dkm/startracker/3d_models/slide_head.stl

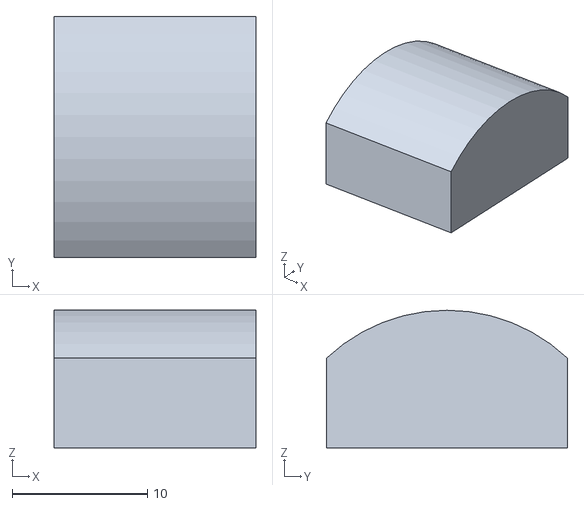
[picture p1: CAD file, 2019-07-14]
3d_models/slide_head.stl
14.9 x 17.8 x 10.2
