dkm/startracker/3d_models/slide_bar.stl

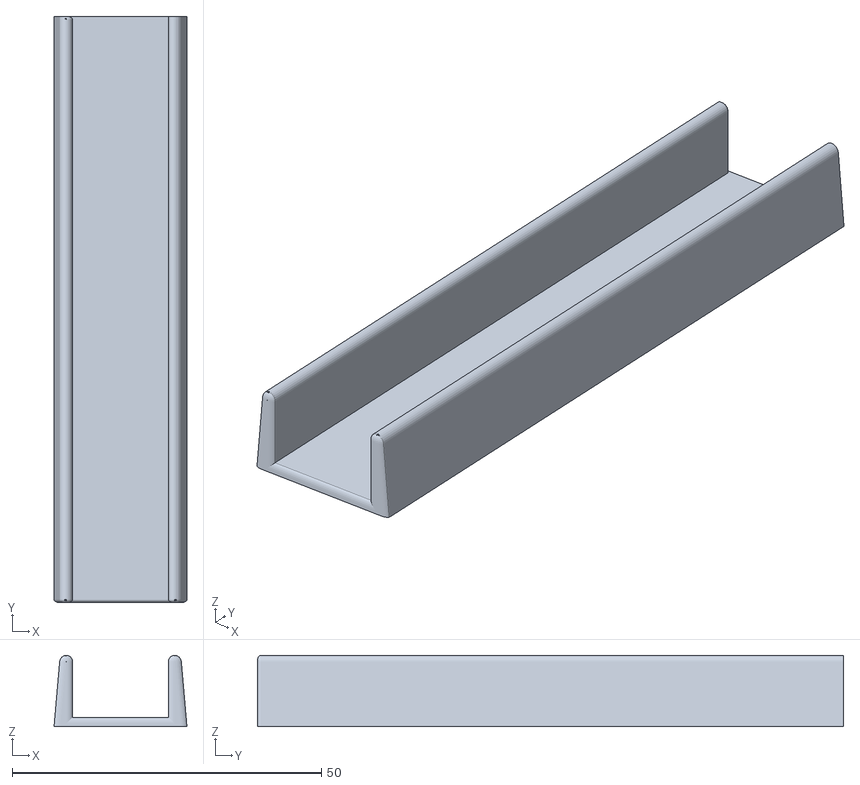
[picture p2: CAD file, 2019-07-14]
3d_models/slide_bar.stl
21.5 x 94.8 x 11.5
