dkm/startracker/3d_models/big_gear.stl

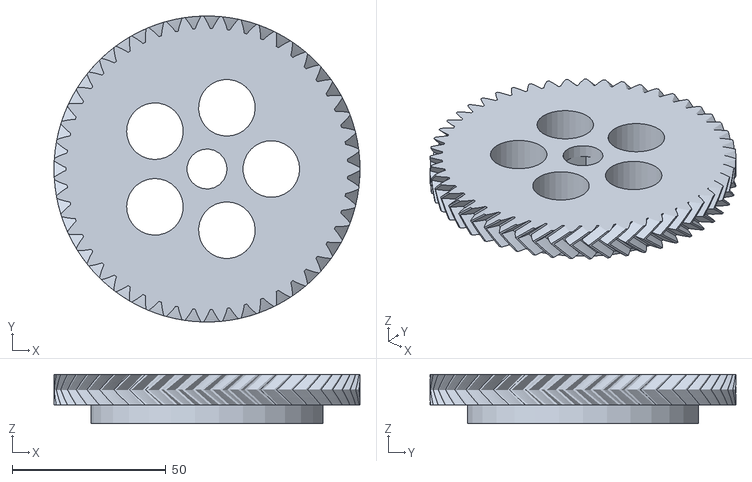
[picture p3: CAD file, 2019-07-06]
3d_models/big_gear.stl
99.4 x 99.4 x 16.0
