dkm/startracker/3d_models/motor_gear.stl

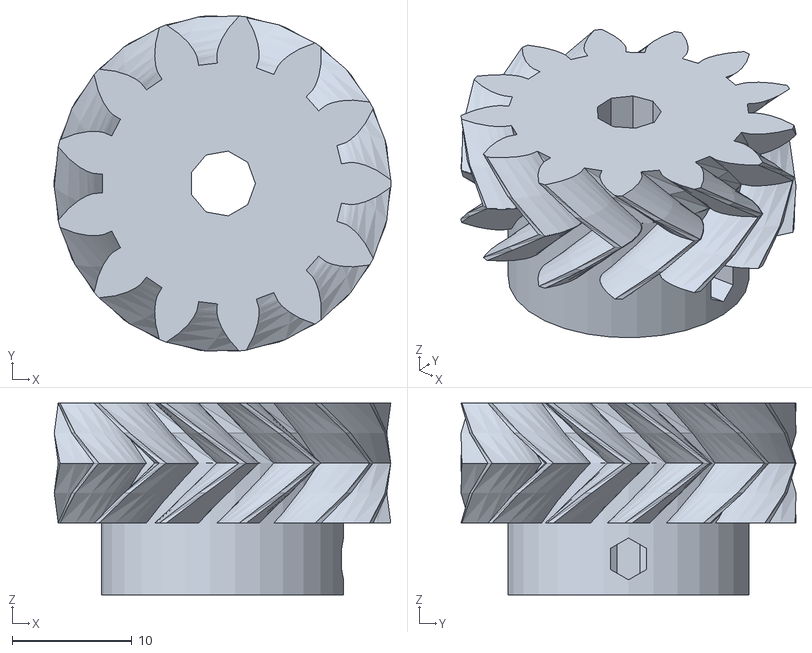
[picture p4: CAD file, 2019-07-06]
3d_models/motor_gear.stl
28.1 x 28.0 x 16.0
