dkm/startracker/3d_models/rod_holder.stl

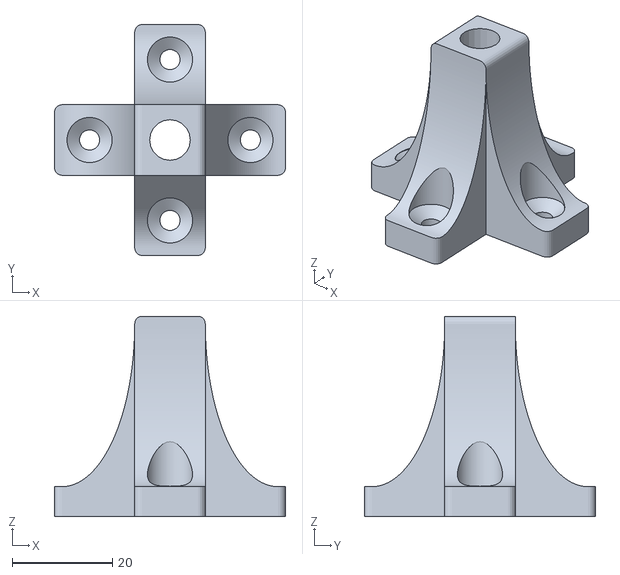
[picture p5: CAD file, 2019-01-20]
3d_models/rod_holder.stl
46.1 x 46.1 x 40.0
