dkm/startracker/3d_models/laser_holder_301.stl

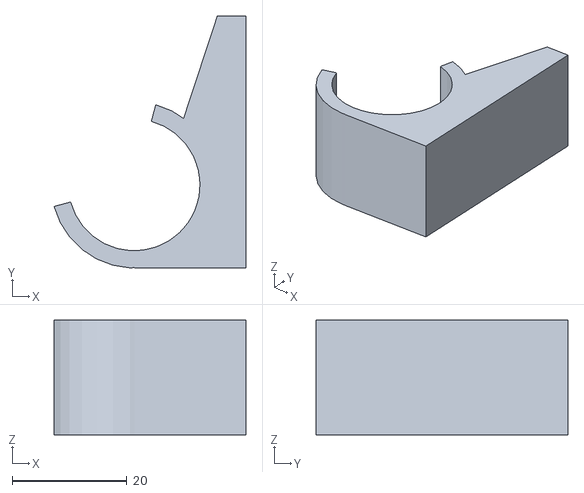
[picture p6: CAD file, 2018-05-30]
3d_models/laser_holder_301.stl
33.5 x 44.0 x 20.0
