dkm/startracker/3d_models/end_stop_pad.stl

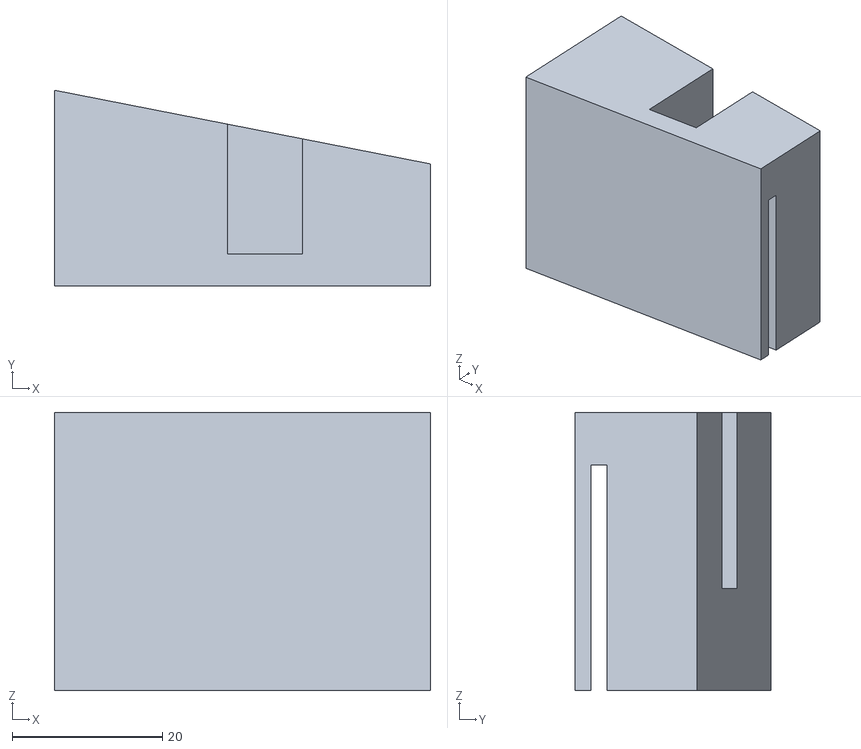
[picture p7: CAD file, 2018-02-28]
3d_models/end_stop_pad.stl
50.0 x 26.0 x 37.0
