dkm/startracker/3d_models/stepper_cover.stl

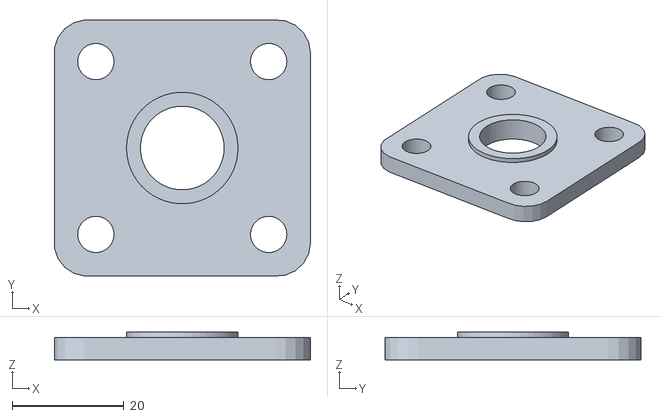
[picture p8: CAD file, 2017-06-23]
3d_models/stepper_cover.stl
45.9 x 46.0 x 5.00
