dkm/startracker/3d_models/rod_cover.stl

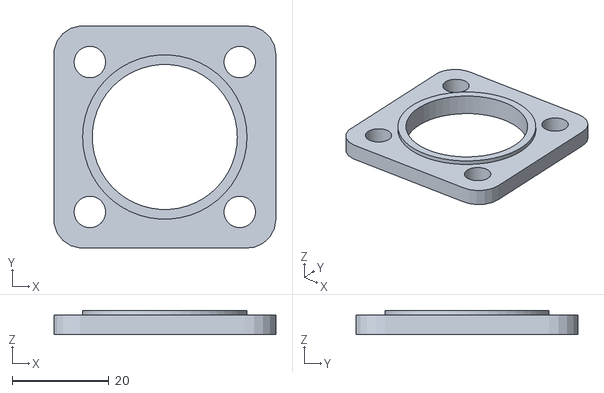
[picture p9: CAD file, 2017-06-21]
3d_models/rod_cover.stl
45.9 x 46.0 x 5.00
