dkm/startracker/3d_models/nema17braket.stl

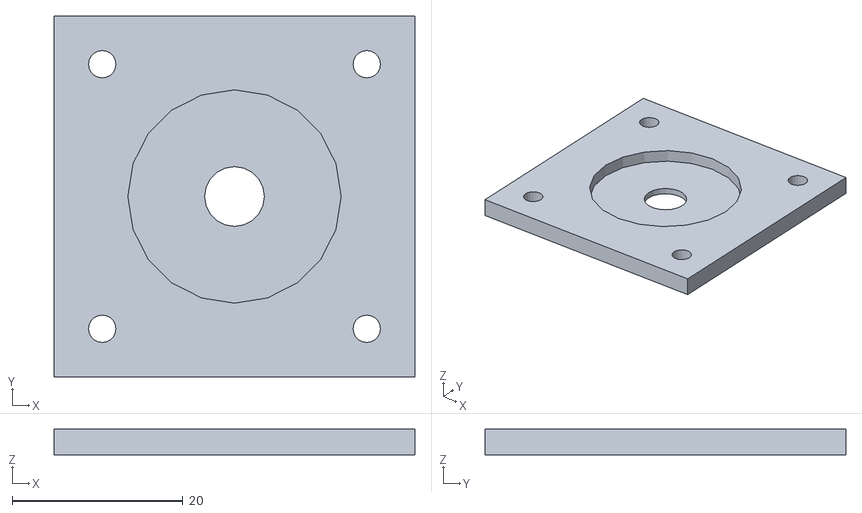
[picture p10: CAD file, 2017-06-19]
3d_models/nema17braket.stl
42.3 x 42.3 x 3.00
