dkm/startracker/3d_models/motor_gear_55shaft.stl

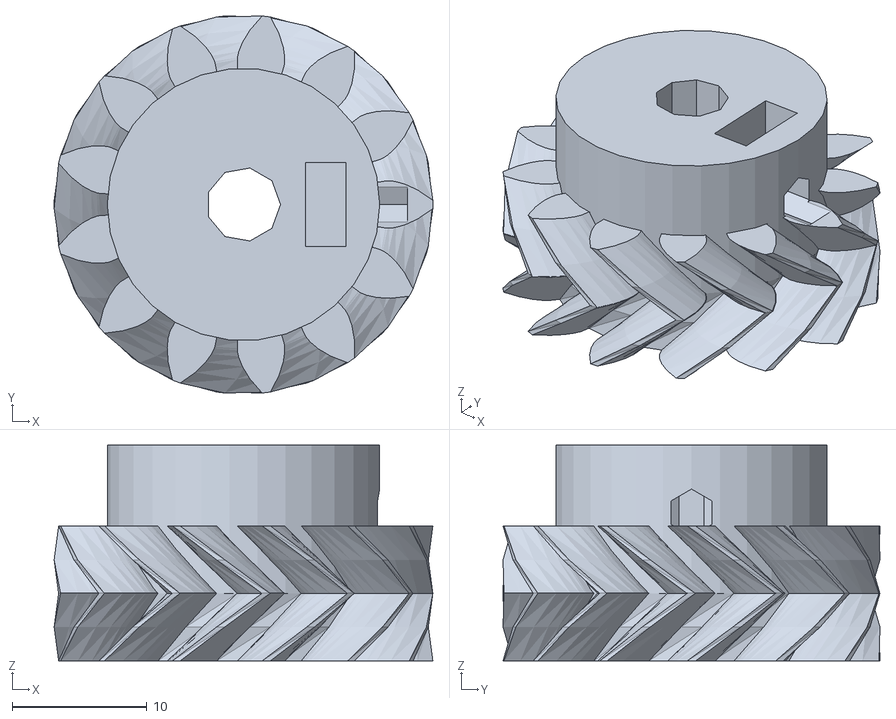
[picture p11: CAD file, 2017-06-19]
3d_models/motor_gear_55shaft.stl
28.1 x 28.0 x 16.0
