dkm/startracker/(list of files, cad)

Other CAD files:
3d_models/rod_cover.scad
