dkm/startracker/(list of files, drawings)

Other design files:
kicad/startracker.dsn
