dkm/startracker/kicad/startracker.kicad_pcb

## KiCad design kicad/startracker.kicad_pcb (2017-06-25)

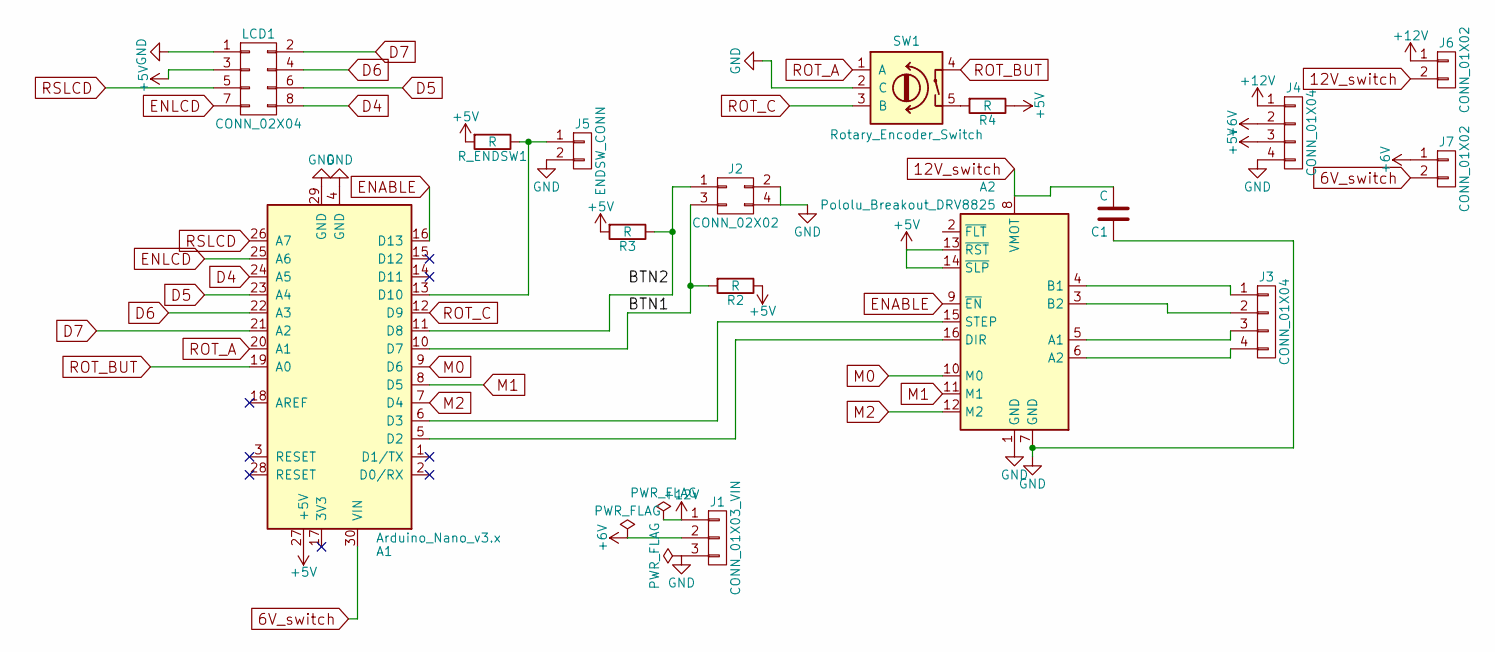
[picture p12: schematic startracker.sch]

Parts:
A1: Arduino_Nano_v3.x; Arduino_Nano_WithMountingHoles
A2: Pololu_Breakout_DRV8825; Pololu_Breakout-16_15.2x20.3mm
C1: C; C_Radial_D8_L11.5_P3.5
J1: CONN_01X03_VIN; JST_PH_B3B-PH-K_03x2.00mm_Straight
J2: CONN_02X02; Pin_Header_Straight_2x02
J3, J4: CONN_01X04; Pin_Header_Straight_1x04
J5: ENDSW_CONN; Pin_Header_Straight_1x02
J6, J7: CONN_01X02; Pin_Header_Straight_1x02
LCD1: CONN_02X04; Pin_Header_Straight_2x04
R2, R3, R4: R; Resistor_Horizontal_RM7mm
R_ENDSW1: R; Resistor_Horizontal_RM7mm
SW1: Rotary_Encoder_Switch; SF-ROTARY-ENCODER

Connections:
6V_switch: A1.30 (VIN), J7.2
12V_switch: A2.8 (VMOT), C1.2, J6.2
+5V: A1.27 (+5V), A2.13 (~RST), A2.14 (~SLP), J4.3, LCD1.3, R2.1, R3.2, R4.1, R_ENDSW1.2
+6V: J1.2, J4.2, J7.1
+12V: J1.1, J4.1, J6.1
/BTN1: A1.10 (D7), J2.3, R2.2
D4: A1.24 (A5), LCD1.8
D5: A1.23 (A4), LCD1.6
D6: A1.22 (A3), LCD1.4
D7: A1.21 (A2), LCD1.2
ENABLE: A1.16 (D13), A2.9 (~EN)
ENLCD: A1.25 (A6), LCD1.7
GND: A1.4 (GND), A1.29 (GND), A2.1 (GND), A2.7 (GND), C1.1, J1.3, J2.2, J2.4, J4.4, J5.2, LCD1.1, SW1.2 (C)
M0: A1.9 (D6), A2.10 (M0)
M1: A1.8 (D5), A2.11 (M1)
M2: A1.7 (D4), A2.12 (M2)
unnamed: A1.5 (D2), A2.16 (DIR)
unnamed: A1.6 (D3), A2.15 (STEP)
unnamed: A1.11 (D8), J2.1, R3.1
unnamed: A1.13 (D10), J5.1, R_ENDSW1.1
unnamed: A2.3 (B2), J3.2
unnamed: A2.4 (B1), J3.1
unnamed: A2.5 (A1), J3.3
unnamed: A2.6 (A2), J3.4
unnamed: R4.2, SW1.5
ROT_A: A1.20 (A1), SW1.1 (A)
ROT_BUT: A1.19 (A0), SW1.4
ROT_C: A1.12 (D9), SW1.3 (B)
RSLCD: A1.26 (A7), LCD1.5

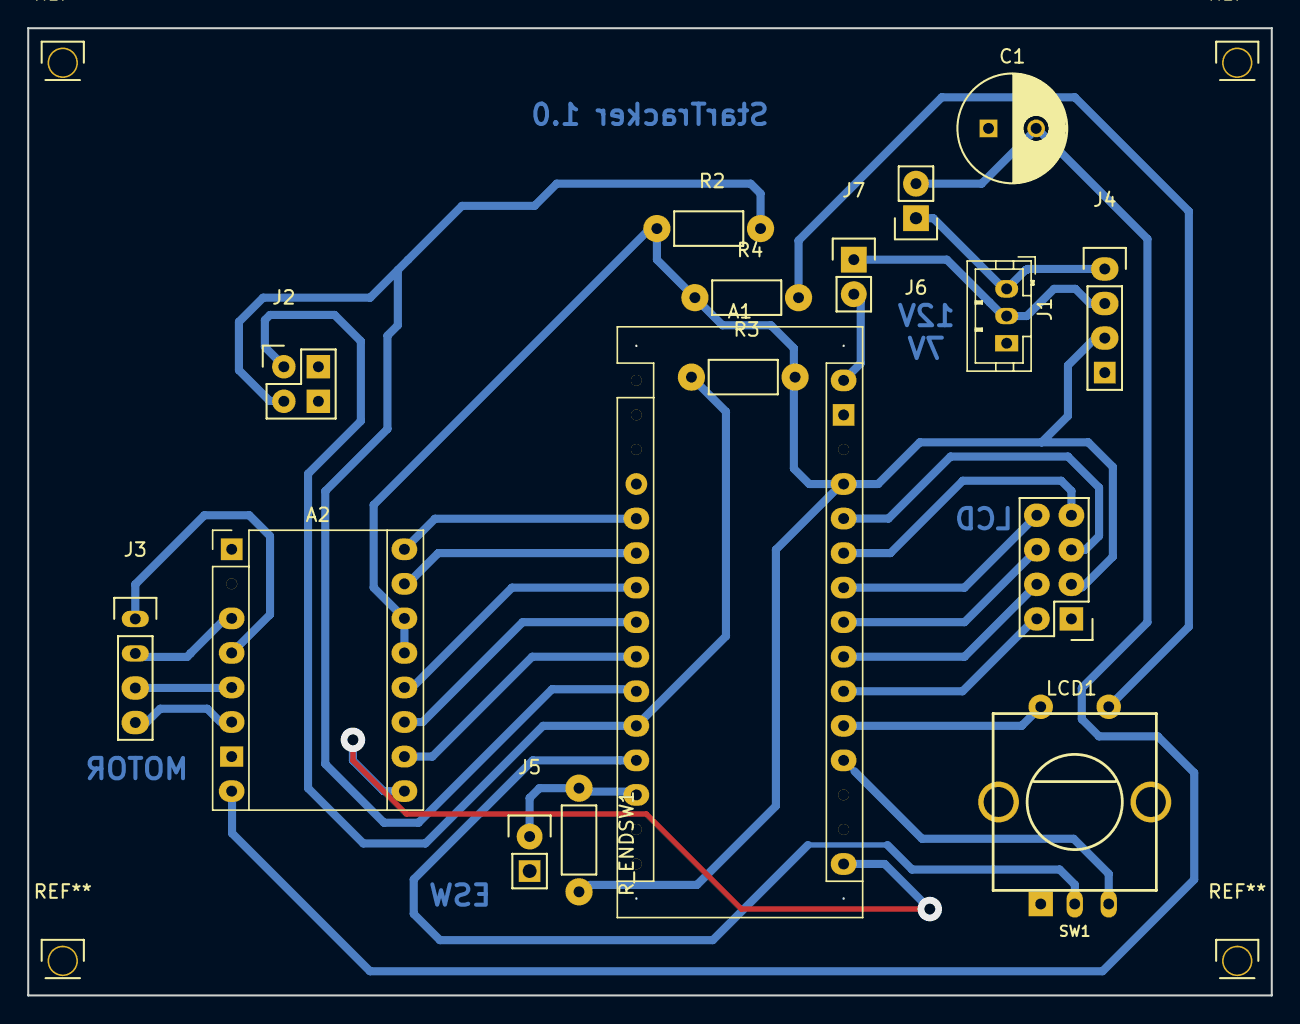
[picture p13: board startracker.kicad_pcb from above]

Board: 2 copper layers, 91.4 x 71.1 mm, 16 parts (0 on the bottom side), 29 nets.
