dkm/startracker/(commit log)

2017-05-15 first kicad draft
    [startracker.kicad_pcb, startracker.sch]
2017-05-15 sample arduino sketch for testing nema17
2017-05-16 making progress on elec sch
    [startracker.sch]
2017-05-19 add some footprint, still some issue with some components
    [startracker.sch]
2017-05-20 first pcb routed on single layer
    [startracker.kicad_pcb, startracker.sch]
2017-05-23 add 7.5V connector
    [startracker.kicad_pcb, startracker.sch]
2017-05-29 PCB fix
    [startracker.kicad_pcb]
2017-06-02 refresh pcb
    [startracker.dsn, startracker.kicad_pcb]
2017-06-08 new pcb version
    [startracker.dsn, startracker.kicad_pcb, startracker.sch]
2017-06-08 use timer1 and use makefile
    use timer1 (initial code)
    use makefile instead of arduino IDE.
2017-06-08 use StepperDriver lib
2017-06-08 add submodule with footprint libs
2017-06-08 update board : use enable, m0, ...
    [startracker.dsn, startracker.kicad_pcb, startracker.sch]
2017-06-09 reworked elec schema + pcb
    [startracker.dsn, startracker.kicad_pcb, startracker.sch]
2017-06-14 rework float computation
    looks like the arduino float is not a good fit for this one: results are
    diverging after few seconds. Fallback to some hardcoded numerical
    values.
    known problem: timer does not tick periodically
    [startracker.ino]
2017-06-15 3D models for gears
    [big_gear.stl, gears.scad, motor_gear.stl]
2017-06-15 fix angle compute + use millis
    [startracker.ino]
2017-06-19 enl4rge gear shaft hole
    [gears.scad, motor_gear_55shaft.stl]
2017-06-19 add nema17 holder plate
    [nema17braket.scad, nema17braket.stl]
2017-06-20 some cleaning + initial code for reset position
    remove dead code commented out
    initial routine for reseting position on long press
    [startracker.ino]
2017-06-20 update current state
2017-06-21 add rod cover model
    used to cover screws around rod and allow for big gear to turn.
    [rod_cover.scad, rod_cover.stl]
2017-06-21 initial work for laster holder
    [laser_holder.scad]
2017-06-21 add endstrop down to pcb
    [startracker.kicad_pcb, startracker.sch]
2017-06-22 minor changes in PCB
    add drill hole in corners
    make all GND pad rectangular
    add labels for connectors
    [startracker.kicad_pcb]
2017-06-22 PCB cleanups
    larger track size, add spacing when possible.
    [startracker.kicad_pcb]
2017-06-23 add switch connectors for both pwr (12 and 7)
    both can be shorted for using only 12V.
    [startracker.kicad_pcb, startracker.sch]
2017-06-23 Add Switch submodule for arduino
    Switch module can be used to debounce push buttons
2017-06-23 control automata basics
    start in IDLE.
    IDLE :: 1 press => RUN ; 2 press => RESET
    RUN :: 1 press => IDLE
    RESET :: end_stop => IDLE
    Stepper direction can be changed.
    Stepper microstepping can be changed.
    Some debug print used.
    [startracker.ino]
2017-06-23 Laser holder work
    Hook size nearly good
    [laser_holder.scad]
2017-06-23 Add 3D model for stepper cover
    [stepper_cover.scad, stepper_cover.stl]
2017-06-25 add weak debug routines + better state change traces
2017-06-25 change microstepping config and rotation freq
    microstepping 2->16
    freq: 0.5Hz -> 5Hz
2017-06-25 refresh config code for stepper direction
2017-06-25 minor changes in PCB
    rework edge cut, refresh some tracks/drill holes.
    [startracker.kicad_pcb]
2017-06-25 add box model (from the Ultimate Box Maker)
    http://heartygfx.blogspot.com
    OpenScad Parametric Box
    CC BY-NC 3.0 License
    [U_Box_V103.scad]
2017-06-25 model for Dolica tripod quick release mount.
    prepare for 4 M3 screws/hexnuts.
    [dolica_quick_Release.scad]
2017-06-25 add initial box model
    Based on Ultimate Box Maker
    https://www.thingiverse.com/thing:1264391
    [box.scad]
2017-06-26 laser holder nearly ready
    [laser_holder.scad]
2017-06-29 fine tune nut holes in laser holder
    [laser_holder.scad]
2017-07-02 change DRV8825 mode pins
    for easier routing, mode pins have swapped.
    [startracker.ino]
2017-07-02 fine tune laser holder
    now, radius may be a bit too large, but at least, the print does not
    brake when fiting laser in place.
    [laser_holder.scad]
2017-07-02 remove old file for box
    [U_Box_V103.scad]
2017-07-04 helper to keep scad and arduino values in sync
    - run teeth_config.sh to sync scad values from gears in arduino code.
    - small reindent
2017-07-06 code cleanup and better trace output.
2017-07-06 disable button 2 and 3
    not yet used and leftover setup conflicts with mode pin for stepper driver.
2017-07-06 minor change in 'native' checker
    use correct gears sizes.
    [native.C, native.py]
2017-07-09 new debug level, change timer arith
    Use a 'moderate' debug level: can have impact on behavior, but is
    still human readable without buffer.
    Use unsigned arith for timer handling and check for underflow.
2017-07-11 box: add mounting slot
    [box.scad]
2017-07-12 box: switch and button holes
    [box.scad]
2017-07-14 cleanup + more helpfull debug trace
2018-02-24 use submodule for arduino makefile
2018-02-24 initial end stop holder. WIP
    [end_stop_pad.scad]
2018-02-25 update end stop model, still not OK
    too tight, nothing fits correctly.
    [end_stop_pad.scad, end_stop_pad.stl]
2018-02-28 add margin for both the plate grip and end stop location.
    [end_stop_pad.scad, end_stop_pad.stl]
2018-05-05 arduino: smoother movements
    increase microstep, reduce lib's RPM and increase freq
2018-05-05 bump arduino-makefile rev to latest master.
2018-05-05 Bump StepperDriver rev
2018-05-13 minor makefile tuning
    Allow for ARDUINO_DIR variable override.
2018-05-13 Relax math precision and let GCC be more agressive
    Use -ffast-math for building C/C++. We don't need to be exact, let GCC
    be more agressive and saves few bytes (currently it saves 80bytes).
2018-05-13 move config in dedicated file, fix initial setup/reset
    Move all user-modifiable variables in config.h. User should only need
    to change items in this file.
    Fix initial setup of the tracker. The initial angle depends on the
    specific build.
    [config.h, startracker.ino]
2018-05-30 add holder for new laser (laser 301)
    [laser_holder_301.scad, laser_holder_301.stl]
2018-09-16 Add rod holder model, replaces the one from jj robots that is not slic3r friendly
    Original work from Clément Leger : https://github.com/clementleger/3d_parts/blob/master/projector_lifter/adjustable_mount.scad
    [rod_holder.scad, rod_holder.stl]
2019-01-20 enl4rge rod holder h0l3
    [rod_holder.scad, rod_holder.stl]
2019-05-04 refresh gears after move away from aluminium plate
    With the wood board replacing the alumnium plate, I need to have
    both gears with the same support.
    [big_gear.stl, motor_gear.stl]
2019-05-22 make big gears rim margin larger
    With a 0 margin, it's not possible to fit the gear because of the
    motor screw.
    [big_gear.stl, gears.scad]
2019-07-06 Flip gears
    My threaded rod was mounted in the other side, so if I want the gears
    to turn in the correct direction, I have to flip them :)
    [big_gear.stl, gears.scad, motor_gear.stl]
2019-07-14 Add missing slide parts from JJrobots
    Original file can be found here : https://www.thingiverse.com/thing:974906/files
    Licensed CC-A
    Add brief for files pulled from other projects.
    [slide_bar.stl, slide_head.stl]
2019-07-17 Change motor shaft diameter
    Looks like printing with good printer makes this hole too large.
    The captive nut then pushes the shaft when thightened unevenly,
    ending up with the gear not turning around the shaft correctly.
    [gears.scad]
2019-07-17 Refine the parameters for having nive arcs
    Set the $fn some some hage value (maybe a bit overkill) so the facets
    are less visible and hopefully the gears smoother.
    [gears.scad]
2019-08-17 Change default arduino SDK version
    Change from 1.8.5 to 1.8.9
2019-08-22 Allow for working with gravity instead of against it
    The hinge_opening config can be used for setup where the hinge is
    closing when working instead of opening.
2019-08-25 Fix init and hinge closing mode
    Init and hinge closing mode were completely wrong.
    [config.h, startracker.ino]
